zephray/PenabledDisplay/pcb/pcb.kicad_pcb

## KiCad design pcb/pcb.kicad_pcb (2022-04-03)

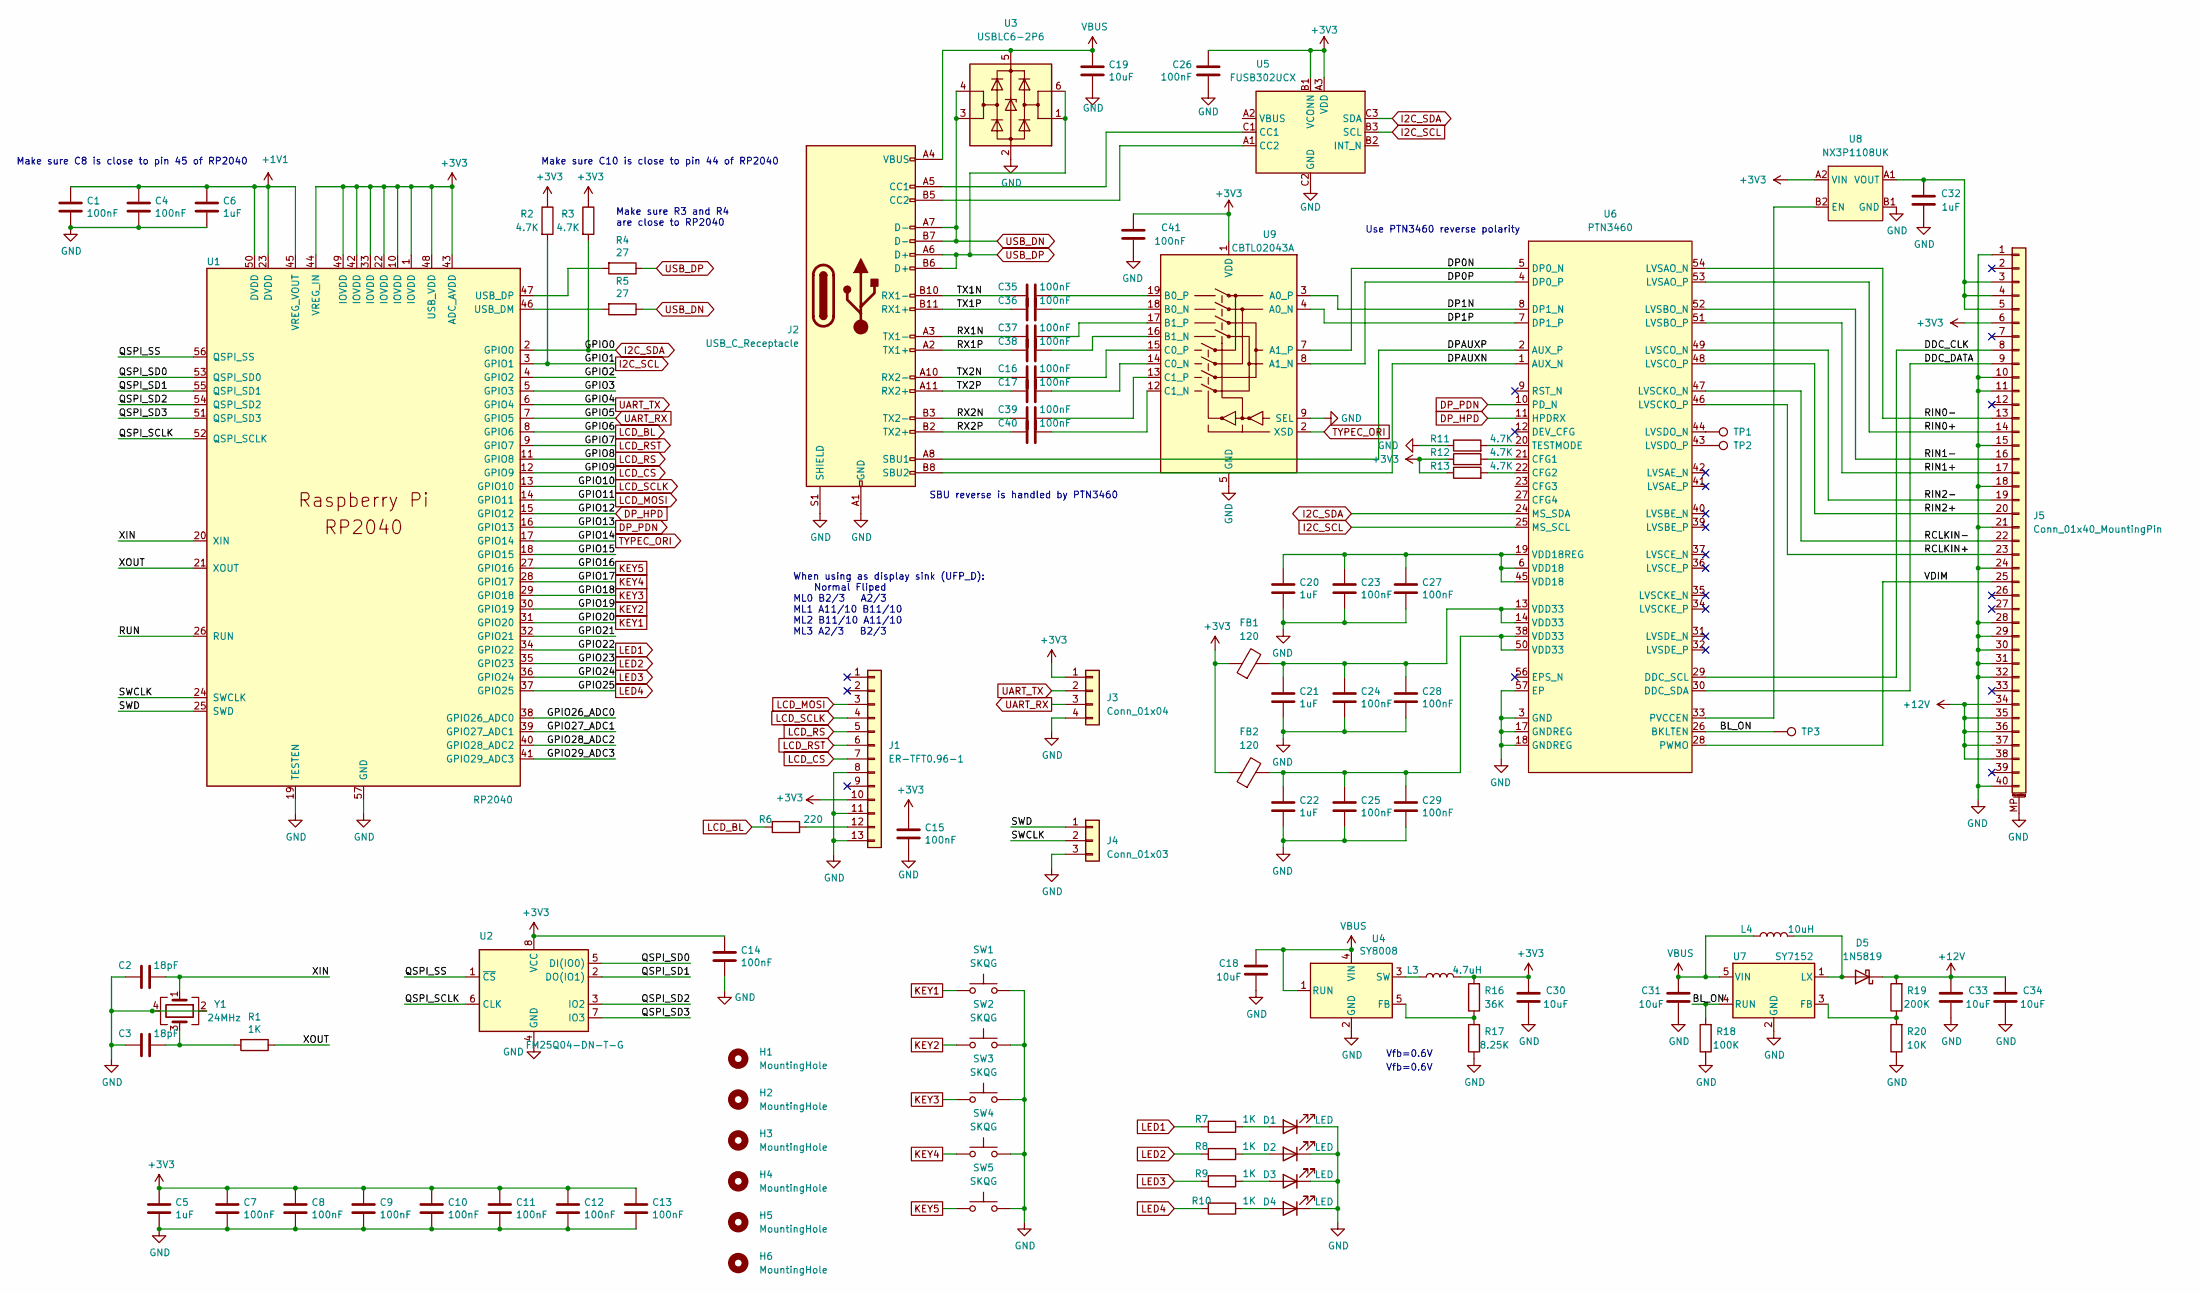
[picture p1: schematic pcb.kicad_sch, PenabledDisplay]

Parts:
C1, C4, C7, C8, C9, C10, C11, C12, C13, C14, C15, C16, C17, C23, C24, C25, C26, C27, C28, C29, C35, C36, C37, C38, C39, C40, C41: 100nF; C_0402_1005Metric
C2, C3: 18pF; C_0402_1005Metric
C5, C6, C20, C21, C22, C32: 1uF; C_0402_1005Metric
C18, C19, C30, C31, C33, C34: 10uF; C_0603_1608Metric
D1, D2, D3, D4: LED; LED_0603_1608Metric
D5: 1N5819; D_SOD-123
FB1, FB2: 120; L_0603_1608Metric
H1, H2: MountingHole; MountingHole_2.2mm_M2_DIN965_Pad
H3: MountingHole; MountingHole_2.2mm_M2_DIN965
H4, H5: MountingHole; MountingHole_2.7mm_M2.5_DIN965_Pad
H6: MountingHole; MountingHole_1.7mm
J1: ER-TFT0.96-1; FPC_13_B
J2: USB_C_Receptacle; USB_C_Receptacle_Amphenol_12401548E4-2A
J3: Conn_01x04; PinHeader_1x04_P1.27mm_Vertical
J4: Conn_01x03; PinHeader_1x03_P2.54mm_Vertical
J5: Conn_01x40_MountingPin; Hirose_FH12-40S-0.5SH_1x40-1MP_P0.50mm_Horizontal_Reversed
L3: 4.7uH; L_Vishay_IHLP-1212
L4: 10uH; L_Vishay_IHLP-1616
R1, R7, R8, R9, R10: 1K; R_0402_1005Metric
R2, R3, R11, R12, R13: 4.7K; R_0402_1005Metric
R4, R5: 27; R_0402_1005Metric
R6: 220; R_0402_1005Metric
R16: 36K; R_0402_1005Metric
R17: 8.25K; R_0402_1005Metric
R18: 100K; R_0402_1005Metric
R19: 200K; R_0402_1005Metric
R20: 10K; R_0402_1005Metric
SW1, SW2, SW3, SW4, SW5: SKQG; SW_SPST_SKQG_WithStem
TP1, TP2, TP3: TestPoint; TestPoint_Pad_D1.0mm
U1: RP2040; QFN-56-1EP_7x7mm_P0.4mm_EP5.6x5.6mm_ThermalVias
U2: FM25Q04-DN-T-G; DFN-8-1EP_3x2mm_P0.5mm_EP1.36x1.46mm
U3: USBLC6-2P6; SOT-666
U4: SY8008; TSOT-23-5
U5: FUSB302UCX; WLP-9_1.448x1.468mm_Layout3x3_P0.4mm_Ball0.27mm_Pad0.25mm
U6: PTN3460; QFN-56-1EP_7x7mm_P0.4mm_EP5.6x5.6mm
U7: SY7152; TSOT-23-6
U8: NX3P1108UK; WLCSP-4-X1-WLB0909-4_0.89x0.89mm_P0.5mm
U9: CBTL02043A; WQFN-20-1EP_2.5x4.5mm_P0.5mm_EP1x2.9mm
Y1: 24MHz; Oscillator_SMD_Abracon_ASE-4Pin_3.2x2.5mm

Connections:
+1V1: C1.1, C4.1, C6.1, U1.23 (DVDD), U1.45 (VREG_VOUT), U1.50 (DVDD)
+3V3: C5.1, C7.1, C8.1, C9.1, C10.1, C11.1, C12.1, C13.1, C14.1, C15.1, C26.1, C30.2, C41.1, FB1.1, FB2.1, J1.10, J3.1, J5.6, L3.2, R2.1, R3.1, R12.1, R13.1, R16.2, U1.1 (IOVDD), U1.10 (IOVDD), U1.22 (IOVDD), U1.33 (IOVDD), U1.42 (IOVDD), U1.43 (ADC_AVDD), U1.44 (VREG_IN), U1.48 (USB_VDD), U1.49 (IOVDD), U2.8 (VCC), U5.A3 (VDD), U5.B1 (VCONN), U8.A2 (VIN), U9.1 (VDD), U9.6 (VDD), U9.10 (VDD)
+12V: C33.2, C34.2, D5.1 (K), J5.34, J5.35, J5.36, J5.37, J5.38, R19.2
/BL_ON: R18.2, TP3.1, U6.26 (BKLTEN), U7.4 (RUN)
/DDC_CLK: J5.8, U6.29 (DDC_SCL)
/DDC_DATA: J5.9, U6.30 (DDC_SDA)
/DP0N: U6.5 (DP0_N), U9.7 (A1_P)
/DP0P: U6.4 (DP0_P), U9.8 (A1_N)
/DP1N: U6.8 (DP1_N), U9.3 (A0_P)
/DP1P: U6.7 (DP1_P), U9.4 (A0_N)
/DPAUXN: J2.B8 (SBU2), U6.1 (AUX_N)
/DPAUXP: J2.A8 (SBU1), U6.2 (AUX_P)
/GPIO2: U1.4 (GPIO2)
/GPIO3: U1.5 (GPIO3)
/GPIO15: U1.18 (GPIO15)
/GPIO21: U1.32 (GPIO21)
/GPIO26_ADC0: U1.38 (GPIO26_ADC0)
/GPIO27_ADC1: U1.39 (GPIO27_ADC1)
/GPIO28_ADC2: U1.40 (GPIO28_ADC2)
/GPIO29_ADC3: U1.41 (GPIO29_ADC3)
/QSPI_SCLK: U1.52 (QSPI_SCLK), U2.6 (CLK)
/QSPI_SD0: U1.53 (QSPI_SD0), U2.5 (DI(IO0))
/QSPI_SD1: U1.55 (QSPI_SD1), U2.2 (DO(IO1))
/QSPI_SD2: U1.54 (QSPI_SD2), U2.3 (IO2)
/QSPI_SD3: U1.51 (QSPI_SD3), U2.7 (IO3)
/QSPI_SS: U1.56 (QSPI_SS), U2.1 (~CS)
/RCLKIN+: J5.23, U6.46 (LVSCKO_P)
/RCLKIN-: J5.22, U6.47 (LVSCKO_N)
/RIN0+: J5.14, U6.53 (LVSAO_P)
/RIN0-: J5.13, U6.54 (LVSAO_N)
/RIN1+: J5.17, U6.51 (LVSBO_P)
/RIN1-: J5.16, U6.52 (LVSBO_N)
/RIN2+: J5.20, U6.48 (LVSCO_P)
/RIN2-: J5.19, U6.49 (LVSCO_N)
/RUN: U1.26 (RUN)
/RX1N: C37.1, J2.A3 (TX1-)
/RX1P: C38.1, J2.A2 (TX1+)
/RX2N: C39.1, J2.B3 (TX2-)
/RX2P: C40.1, J2.B2 (TX2+)
/SWCLK: J4.2, U1.24 (SWCLK)
/SWD: J4.1, U1.25 (SWD)
/TX1N: C35.1, J2.B10 (RX1-)
/TX1P: C36.1, J2.B11 (RX1+)
/TX2N: C16.1, J2.A10 (RX2-)
/TX2P: C17.1, J2.A11 (RX2+)
/VDIM: J5.25, U6.28 (PWMO)
/XIN: C2.1, U1.20 (XIN), Y1.1
/XOUT: R1.1, U1.21 (XOUT)
DP_HPD: U1.15 (GPIO12), U6.11 (HPDRX)
DP_PDN: U1.16 (GPIO13), U6.10 (PD_N)
GND: C1.2, C2.2, C3.2, C4.2, C5.2, C6.2, C7.2, C8.2, C9.2, C10.2, C11.2, C12.2, C13.2, C14.2, C15.2, C18.1, C19.2, C20.2, C21.2, C22.2, C23.2, C24.2, C25.2, C26.2, C27.2, C28.2, C29.2, C30.1, C31.1, C32.1, C33.1, C34.1, C41.2, D1.1 (K), D2.1 (K), D3.1 (K), D4.1 (K), J1.8, J1.11, J1.13, J2.A1 (GND), J2.A12 (GND), J2.B1 (GND), J2.B12 (GND), J2.S1 (SHIELD), J3.4, J4.3, J5.1, J5.10, J5.11, J5.15, J5.18, J5.21, J5.24, J5.28, J5.29, J5.30, J5.31, J5.32, J5.40, J5.MP (MountPin), R11.1, R17.1, R18.1, R20.1, SW1.2, SW2.2, SW3.2, SW4.2, SW5.2, U1.19 (TESTEN), U1.57 (GND), U2.4 (GND), U3.2 (GND), U4.2 (GND), U5.C2 (GND), U6.3 (GND), U6.17 (GNDREG), U6.18 (GNDREG), U6.57 (EP), U7.2 (GND), U8.B1 (GND), U9.5 (GND), U9.9 (SEL), U9.11 (GND), U9.20 (GND), U9.21 (GND), Y1.2, Y1.4
I2C_SCL: R2.2, U1.3 (GPIO1), U5.B3 (SCL), U6.25 (MS_SCL)
I2C_SDA: R3.2, U1.2 (GPIO0), U5.C3 (SDA), U6.24 (MS_SDA)
KEY1: SW1.1, U1.31 (GPIO20)
KEY2: SW2.1, U1.30 (GPIO19)
KEY3: SW3.1, U1.29 (GPIO18)
KEY4: SW4.1, U1.28 (GPIO17)
KEY5: SW5.1, U1.27 (GPIO16)
LCD_BL: R6.2, U1.8 (GPIO6)
LCD_CS: J1.7, U1.12 (GPIO9)
LCD_MOSI: J1.3, U1.14 (GPIO11)
LCD_RS: J1.5, U1.11 (GPIO8)
LCD_RST: J1.6, U1.9 (GPIO7)
LCD_SCLK: J1.4, U1.13 (GPIO10)
LED1: R7.2, U1.34 (GPIO22)
LED2: R8.2, U1.35 (GPIO23)
LED3: R9.2, U1.36 (GPIO24)
LED4: R10.2, U1.37 (GPIO25)
unnamed: C3.1, R1.2, Y1.3
unnamed: C16.2, U9.15 (C0_P)
unnamed: C17.2, U9.14 (C0_N)
unnamed: C20.1, C23.1, C27.1, U6.6 (VDD18), U6.19 (VDD18REG), U6.45 (VDD18)
unnamed: C21.1, C24.1, C28.1, FB1.2, U6.13 (VDD33), U6.14 (VDD33)
unnamed: C22.1, C25.1, C29.1, FB2.2, U6.38 (VDD33), U6.50 (VDD33)
unnamed: C32.2, J5.3, J5.4, J5.5, U8.A1 (VOUT)
unnamed: C35.2, U9.19 (B0_P)
unnamed: C36.2, U9.18 (B0_N)
unnamed: C37.2, U9.17 (B1_P)
unnamed: C38.2, U9.16 (B1_N)
unnamed: C39.2, U9.13 (C1_P)
unnamed: C40.2, U9.12 (C1_N)
unnamed: D1.2 (A), R7.1
unnamed: D2.2 (A), R8.1
unnamed: D3.2 (A), R9.1
unnamed: D4.2 (A), R10.1
unnamed: D5.2 (A), L4.2, U7.1 (LX)
unnamed: J1.12, R6.1
unnamed: J2.A5 (CC1), U5.C1 (CC1)
unnamed: J2.B5 (CC2), U5.A1 (CC2)
unnamed: L3.1, U4.3 (SW)
unnamed: R4.2, U1.47 (USB_DP)
unnamed: R5.2, U1.46 (USB_DM)
unnamed: R11.2, U6.20 (TESTMODE)
unnamed: R12.2, U6.21 (CFG1)
unnamed: R13.2, U6.22 (CFG2)
unnamed: R16.1, R17.2, U4.5 (FB)
unnamed: R19.1, R20.2, U7.3 (FB)
unnamed: TP1.1, U6.44 (LVSDO_N)
unnamed: TP2.1, U6.43 (LVSDO_P)
unnamed: U6.33 (PVCCEN), U8.B2 (EN)
TYPEC_ORI: U1.17 (GPIO14), U9.2 (XSD)
UART_RX: J3.3, U1.7 (GPIO5)
UART_TX: J3.2, U1.6 (GPIO4)
USB_DN: J2.A7 (D-), J2.B7 (D-), R5.1, U3.3 (I/O2), U3.4 (I/O2)
USB_DP: J2.A6 (D+), J2.B6 (D+), R4.1, U3.1 (I/O1), U3.6 (I/O1)
VBUS: C18.2, C19.1, C31.2, J2.A4 (VBUS), J2.A9 (VBUS), J2.B4 (VBUS), J2.B9 (VBUS), L4.1, U3.5 (VBUS), U4.1 (RUN), U4.4 (VIN), U7.5 (VIN)

Notes on the sheet:
Vfb=0.6V
Make sure C8 is close to pin 45 of RP2040
Use PTN3460 reverse polarity
SBU reverse is handled by PTN3460
Make sure C10 is close to pin 44 of RP2040
Make sure R3 and R4 are close to RP2040
When using as display sink (UFP_D): Normal Fliped ML0 B2/3 A2/3 ML1 A11/10 B11/10 ML2 B11/10 A11/10 ML3 A2/3 B2/3

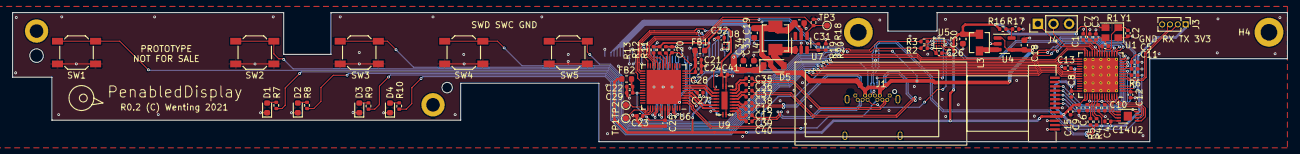
[picture p2: board pcb.kicad_pcb from above]

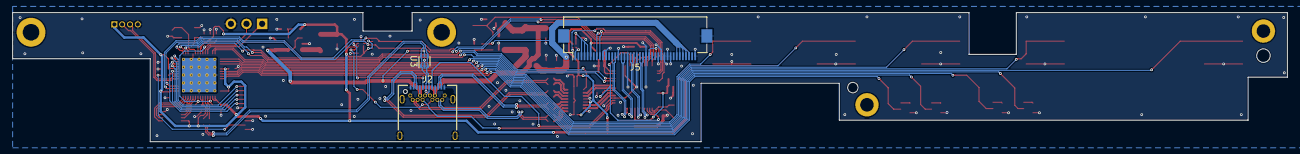
[picture p3: board pcb.kicad_pcb from below]

Board: 4 copper layers, 207.4 x 21.0 mm, 97 parts (3 on the bottom side), 97 nets.
