zephray/PenabledDisplay/fw/lcd.c

//
// Copyright 2021 Wenting Zhang <zephray@outlook.com>
//
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
#include <stdint.h>
#include "pico/stdlib.h"
#include "hardware/spi.h"
#include "hardware/dma.h"
#include "hardware/irq.h"
#include "lcd.h"

// Hardware Connection
#define LCD_SPI  spi1
#define LCD_SPI_DREQ DREQ_SPI1_TX
#define LCD_BL	 6
#define LCD_RST  7
#define LCD_RS   8
#define LCD_CS   9
#define LCD_SCK  10
#define LCD_MOSI 11
#define LCD_SPI_FREQ (20*1000*1000)

uint16_t framebuffer[LCD_WIDTH * LCD_HEIGHT];
static int lcd_dma;
static volatile bool lcd_busy;
static volatile bool lcd_update_req;

static void lcd_select(void) {
    gpio_put(LCD_CS, 0);
}

static void lcd_deselect(void) {
    gpio_put(LCD_CS, 1);
}

static void lcd_mode_command(void) {
    gpio_put(LCD_RS, 0);
}

static void lcd_mode_data(void) {
    gpio_put(LCD_RS, 1);
}

static void lcd_reset(void) {
    gpio_put(LCD_RST, 0);
    sleep_ms(200);
    gpio_put(LCD_RST, 1);
    sleep_ms(20);
}

static void lcd_send_byte(uint8_t byte) {
    lcd_select();
    spi_write_blocking(LCD_SPI, &byte, 1);
    lcd_deselect();
}

static void lcd_send_cmd(uint8_t cmd) {
    lcd_mode_command();
    lcd_send_byte(cmd);
}

static void lcd_send_dat(uint8_t dat) {
    lcd_mode_data();
    lcd_send_byte(dat);
}

static void lcd_send_word(uint16_t word) {
    lcd_mode_data();
    lcd_send_byte(word >> 8);
    lcd_send_byte(word);
}

static void lcd_send_buffer() {
    lcd_mode_data();
    lcd_select();
#if 0
    spi_write_blocking(LCD_SPI, framebuffer, sizeof(framebuffer));
    lcd_deselect();
#else
	// Don't start until the last transmission has finished
	lcd_update_req = 1;
	if (!lcd_busy) {
		lcd_update_req = 0;
		lcd_busy = true;
		dma_channel_set_read_addr(lcd_dma, framebuffer, false);
		dma_channel_set_trans_count(lcd_dma, sizeof(framebuffer), true);
	}
#endif
}

// This interrupt should be at the lowest priority
static void lcd_dma_isr() {
	dma_hw->ints0 = 1u << lcd_dma;
	// Wait till the FIFO is drained and all bytes are sent
	while ((spi_get_hw(LCD_SPI)->sr & SPI_SSPSR_BSY_BITS));
	lcd_deselect();
	lcd_busy = false;
	if (lcd_update_req) {
		lcd_update_req = 0;
		lcd_send_buffer();
	}
}

void lcd_init(void) {
    // Configure Pins
	gpio_set_function(LCD_BL,   GPIO_FUNC_SIO);
	gpio_set_function(LCD_RST,  GPIO_FUNC_SIO);
	gpio_set_function(LCD_RS,   GPIO_FUNC_SIO);
    gpio_set_function(LCD_CS,   GPIO_FUNC_SIO);
    gpio_set_function(LCD_SCK,  GPIO_FUNC_SPI);
    gpio_set_function(LCD_MOSI, GPIO_FUNC_SPI);

	lcd_deselect();
	gpio_put(LCD_BL, 0);
	gpio_set_dir(LCD_BL,  GPIO_OUT);
	gpio_set_dir(LCD_RST, GPIO_OUT);
	gpio_set_dir(LCD_RS,  GPIO_OUT);
	gpio_set_dir(LCD_CS,  GPIO_OUT);

    // Configure SPI
    spi_init(LCD_SPI, LCD_SPI_FREQ);

    // Set up DMA
	lcd_dma = dma_claim_unused_channel(true);
	dma_channel_config c = dma_channel_get_default_config(lcd_dma);
	channel_config_set_transfer_data_size(&c, DMA_SIZE_8);
	channel_config_set_dreq(&c, LCD_SPI_DREQ);
	channel_config_set_read_increment(&c, true);
	channel_config_set_write_increment(&c, false);
	dma_channel_configure(lcd_dma, &c, &spi_get_hw(LCD_SPI)->dr, framebuffer,
			sizeof(framebuffer), false);
	dma_channel_set_irq0_enabled(lcd_dma, true);
	irq_set_exclusive_handler(DMA_IRQ_0, lcd_dma_isr);
	irq_set_enabled(DMA_IRQ_0, true);

    // Reset LCD
    lcd_deselect();

    lcd_reset();

    // Send initialization sequence 
	lcd_send_cmd(0x11);	// turn off sleep mode
	sleep_ms(100);

	lcd_send_cmd(0x21);	// display inversion mode

	lcd_send_cmd(0xB1);	// Set the frame frequency of the full colors normal mode
						// Frame rate=fosc/((RTNA x 2 + 40) x (LINE + FPA + BPA +2))
						// fosc = 850kHz
	lcd_send_dat(0x05);	// RTNA
	lcd_send_dat(0x3A);	// FPA
	lcd_send_dat(0x3A);	// BPA

	lcd_send_cmd(0xB2);	// Set the frame frequency of the Idle mode
						// Frame rate=fosc/((RTNB x 2 + 40) x (LINE + FPB + BPB +2))
						// fosc = 850kHz
	lcd_send_dat(0x05);	// RTNB
	lcd_send_dat(0x3A);	// FPB
	lcd_send_dat(0x3A);	// BPB

	lcd_send_cmd(0xB3);	// Set the frame frequency of the Partial mode/ full colors
	lcd_send_dat(0x05);  
	lcd_send_dat(0x3A);
	lcd_send_dat(0x3A);
	lcd_send_dat(0x05);
	lcd_send_dat(0x3A);
	lcd_send_dat(0x3A);

	lcd_send_cmd(0xB4);
	lcd_send_dat(0x03);

	lcd_send_cmd(0xC0);
	lcd_send_dat(0x62);
	lcd_send_dat(0x02);
	lcd_send_dat(0x04);

	lcd_send_cmd(0xC1);
	lcd_send_dat(0xC0);

	lcd_send_cmd(0xC2);
	lcd_send_dat(0x0D);
	lcd_send_dat(0x00);

	lcd_send_cmd(0xC3);
	lcd_send_dat(0x8D);
	lcd_send_dat(0x6A);   

	lcd_send_cmd(0xC4);
	lcd_send_dat(0x8D); 
	lcd_send_dat(0xEE); 

	lcd_send_cmd(0xC5);  /*VCOM*/
	lcd_send_dat(0x0E);    

	lcd_send_cmd(0xE0);
	lcd_send_dat(0x10);
	lcd_send_dat(0x0E);
	lcd_send_dat(0x02);
	lcd_send_dat(0x03);
	lcd_send_dat(0x0E);
	lcd_send_dat(0x07);
	lcd_send_dat(0x02);
	lcd_send_dat(0x07);
	lcd_send_dat(0x0A);
	lcd_send_dat(0x12);
	lcd_send_dat(0x27);
	lcd_send_dat(0x37);
	lcd_send_dat(0x00);
	lcd_send_dat(0x0D);
	lcd_send_dat(0x0E);
	lcd_send_dat(0x10);

	lcd_send_cmd(0xE1);
	lcd_send_dat(0x10);
	lcd_send_dat(0x0E);
	lcd_send_dat(0x03);
	lcd_send_dat(0x03);
	lcd_send_dat(0x0F);
	lcd_send_dat(0x06);
	lcd_send_dat(0x02);
	lcd_send_dat(0x08);
	lcd_send_dat(0x0A);
	lcd_send_dat(0x13);
	lcd_send_dat(0x26);
	lcd_send_dat(0x36);
	lcd_send_dat(0x00);
	lcd_send_dat(0x0D);
	lcd_send_dat(0x0E);
	lcd_send_dat(0x10);

	lcd_send_cmd(0x3A);	// define the format of RGB picture data
	lcd_send_dat(0x05);	// 16-bit/pixel

	lcd_send_cmd(0x36);
#ifdef LCD_HORIZONTAL
	lcd_send_dat(0x78); // 0x08 0xc8 0x78 0xa8, direction control
#else
	lcd_send_dat(0x08);
#endif

	lcd_send_cmd(0x29);	// Display On

    lcd_set_window(0, 0, LCD_WIDTH - 1, LCD_HEIGHT - 1);

	lcd_busy = false;
	lcd_update_req = false;

	gpio_put(LCD_BL, 1);
}

void lcd_set_window(uint16_t x1, uint16_t y1, uint16_t x2, uint16_t y2) {
    lcd_send_cmd(0x2a);
    lcd_send_word(x1 + LCD_OFFSET_X);
    lcd_send_word(x2 + LCD_OFFSET_X);
    lcd_send_cmd(0x2b);
    lcd_send_word(y1 + LCD_OFFSET_Y);
    lcd_send_word(y2 + LCD_OFFSET_Y);
    lcd_send_cmd(0x2c);
}

void lcd_update(void) {
    lcd_send_buffer();
}
