zephray/PenabledDisplay/(commit log)

2021-03-11 PCB Rev 0.1
    [pcb.kicad_pcb, pcb.kicad_sch]
2022-04-03 pcb: rev 0.2
    [pcb.kicad_pcb, pcb.kicad_sch]
